jamesfs912/AWG/PCB/PCB_Rev2AFinal/awg.kicad_pcb

## KiCad design PCB/PCB_Rev2AFinal/awg.kicad_pcb (2023-10-04)

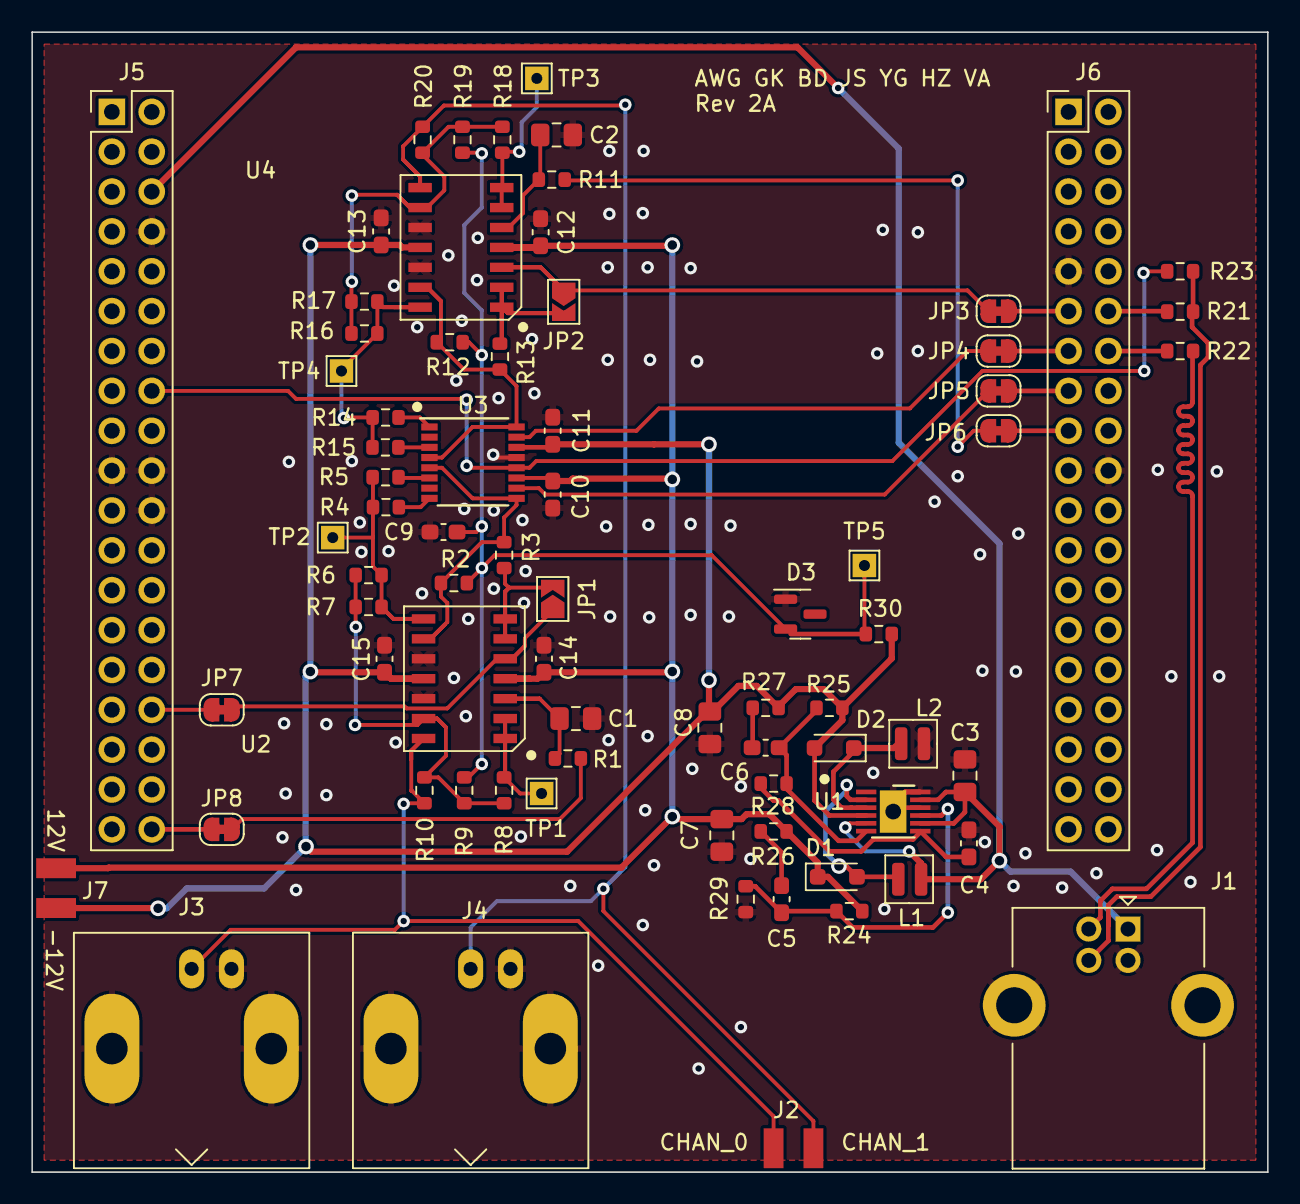
[picture p1: board awg.kicad_pcb from above]

Board: 2 copper layers, 78.7 x 72.6 mm, 74 parts (0 on the bottom side), 47 nets.

Parts:
C1, C2, C3, C7, C8: 10u; C_0805_2012Metric_Pad1.18x1.45mm_HandSolder
C4, C9, C10, C11, C12, C13, C14, C15: 100n; C_0603_1608Metric_Pad1.08x0.95mm_HandSolder
C5, C6: 120p; C_0603_1608Metric_Pad1.08x0.95mm_HandSolder
D1, D2: NSR0530; D_SOD-323_HandSoldering
D3: LM4040-5; SOT-23
J1: USB_B; USB_B_Lumberg_2411_02_Horizontal
J2: 02x02; 2x02
J3, J4: BNC; BNC_Amphenol_B6252HB-NPP3G-50_Horizontal
J5: nuc303_LEFT; PinHeader_2x19_P2.54mm_Vertical
J6: nuc303_RIGHT; PinHeader_2x19_P2.54mm_Vertical
J7: 2x01; 1x02
JP1, JP2: SJ; SolderJumper-2_P1.3mm_Open_TrianglePad1.0x1.5mm
JP3, JP4, JP5, JP6, JP7, JP8: JP; SolderJumper-2_P1.3mm_Bridged_RoundedPad1.0x1.5mm
L1, L2: 4.7u; NRH2410
R1, R2, R5, R6, R7, R9, R10, R11, R12, R15, R16, R17, R19, R20, R28, R29: 10K; R_0603_1608Metric
R3, R8, R13, R18: 3K3; R_0603_1608Metric
R4, R14, R26, R27, R30: 1K; R_0603_1608Metric
R21, R22: 22; R_0603_1608Metric
R23: 1K5; R_0603_1608Metric
R24: 110k; R_0603_1608Metric
R25: 100k; R_0603_1608Metric
TP1, TP2, TP3, TP4, TP5: TestPoint; TestPoint_THTPad_1.5x1.5mm_Drill0.7mm
U1: r1283; DFN-12
U2, U4: Opamp_Quad; SOIC-14
U3: DG403; TSSOP-16-1EP_4.4x5mm_P0.65mm

Connections:
+3.3V: J5.16 (3V3), R23.2, U3.12 (VL)
+5V: C3.1, J1.1 (VBUS), J5.6 (E5V), L1.1, U1.5 (CE), U1.8 (Vcc), U1.11 (PVcc)
+12V: C7.1, C10.2, C12.1, C14.1, D1.1 (K), J7.1, R24.1, R26.1, U2.4 (V+), U3.11 (V+), U4.4 (V+)
-5V: C9.1, D3.2 (A), R2.1, R9.2, R12.1, R19.2, R30.1, TP5.1
-12V: C8.2, C11.2, C13.2, C15.2, D2.2 (A), J7.2, R25.1, R27.1, R30.2, U1.4 (Voutn), U2.11 (V-), U3.14 (V-), U4.11 (V-)
/C0_FB: R2.2, R3.2, U2.9 (-), U3.5 (S4), U3.9 (S2)
/C0_IN: JP1.1 (A), JP7.2 (B), U2.5 (+)
/C0_OUT_G: R4.2, R5.2, R6.2, R7.1, TP2.1, U2.8
/C0_OUT_GO: J2.1, J3.1 (In), R10.2, U2.14
/C0_PWM_OFF: JP8.2 (B), R1.1
/C0_S_GAIN: JP5.1 (A), U3.10 (IN2)
/C0_V_OFF: R8.1, TP1.1, U2.1, U2.2 (-)
/C1_FB: R12.2, R13.2, U3.4 (S3), U3.16 (S1), U4.13 (-)
/C1_IN: JP2.1 (A), JP3.1 (A), U4.3 (+)
/C1_OUT_G: R14.2, R15.1, R16.1, R17.1, TP4.1, U4.14
/C1_OUT_GO: J2.2, J4.1 (In), R20.2, U4.8
/C1_PWM_OFF: JP6.1 (A), R11.1
/C1_S_GAIN: JP4.1 (A), U3.15 (IN1)
/C1_V_OFF: R18.1, TP3.1, U4.6 (-), U4.7
/D+: J1.3 (D+), R21.2, R23.1
/D-: J1.2 (D-), R22.2
/USB_D+: J6.12 (PA12), R21.1
/USB_D-: J6.14 (PA11), R22.1
GND: C1.2, C2.2, C3.2, C4.2, C7.2, C8.1, C9.2, C10.1, C11.1, C12.2, C13.1, C14.2, C15.1, D3.1 (K), J1.4 (GND), J1.5 (Shield), J2.3, J2.4, J3.2 (Ext), J4.2 (Ext), J5.8 (GND), J5.19 (GND), J5.20 (GND), J5.22 (GND), J6.9 (GND), J6.20 (GND), L2.2, R29.1, U1.10 (GND), U1.12 (PGND), U1.13 (GND), U2.10 (+), U2.12 (+), U3.13 (GND), U4.10 (+), U4.12 (+)
unnamed: C5.1, R26.2
unnamed: C6.1, R27.2
unnamed: D1.2 (A), L1.2, U1.2 (Lx1)
unnamed: D2.1 (K), L2.1, U1.3 (Lx2)
unnamed: J5.32 (PA4), JP7.1 (A)
unnamed: J5.38 (PC0), JP8.1 (A)
unnamed: J6.11 (PA5), JP3.2 (B)
unnamed: J6.13 (PA6), JP4.2 (B)
unnamed: J6.15 (PA7), JP5.2 (B)
unnamed: J6.17 (PB6), JP6.2 (B)
unnamed: JP1.2 (B), R3.1, U2.6 (-), U2.7
unnamed: JP2.2 (B), R13.1, U4.1, U4.2 (-)
unnamed: C5.2, R24.2, R29.2, U1.9 (Vfb1)
unnamed: C6.2, R25.2, R28.1, U1.6 (Vfb2)
unnamed: C4.1, R28.2, U1.7 (Vref)
unnamed: C1.1, R1.2, U2.3 (+)
unnamed: R6.1, R7.2, R8.2, R9.1, R10.1, U2.13 (-)
unnamed: R14.1, U3.1 (D1)
unnamed: R15.2, U3.3 (D3)
unnamed: R4.1, U3.8 (D2)
unnamed: R5.1, U3.6 (D4)
unnamed: C2.1, R11.2, U4.5 (+)
unnamed: R16.2, R17.2, R18.2, R19.1, R20.1, U4.9 (-)
