jamesfs912/AWG/MCU/Core/Src/main.c

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
/* Includes ------------------------------------------------------------------*/
#include "main.h"
#include "usb_device.h"

/* USER CODE BEGIN Includes */
#include "interface.h"
/* USER CODE END Includes */

DAC_HandleTypeDef hdac1;
DMA_HandleTypeDef hdma_dac1_ch1;
DMA_HandleTypeDef hdma_dac1_ch2;

TIM_HandleTypeDef htim2;
TIM_HandleTypeDef htim6;
TIM_HandleTypeDef htim7;

/* USER CODE BEGIN PV */
uint16_t dc_volt1[256] = {2048, 2048};

/* USER CODE END PV */

void SystemClock_Config(void);
static void MX_GPIO_Init(void);
static void MX_DMA_Init(void);
static void MX_DAC1_Init(void);
static void MX_TIM2_Init(void);
static void MX_TIM6_Init(void);
static void MX_TIM7_Init(void);
/**
  * @brief  The application entry point.
  * @retval int
  */
int main(void)
{
  /* MCU Configuration--------------------------------------------------------*/

  /* Reset of all peripherals, Initializes the Flash interface and the Systick. */
  HAL_Init();

  /* Configure the system clock */
  SystemClock_Config();

  /* Initialize all configured peripherals */
  MX_GPIO_Init();
  MX_DMA_Init();
  MX_USB_DEVICE_Init();
  MX_DAC1_Init();
  MX_TIM2_Init();
  MX_TIM6_Init();
  MX_TIM7_Init();
  /* USER CODE BEGIN 2 */

  HAL_DAC_Start_DMA(&hdac1, DAC_CHANNEL_1, (uint32_t*) dc_volt1, (uint32_t) 2, DAC_ALIGN_12B_R);
  HAL_TIM_Base_Start(&htim6);
  HAL_DAC_Start_DMA(&hdac1, DAC_CHANNEL_2, (uint32_t*) dc_volt1, (uint32_t) 2, DAC_ALIGN_12B_R);
  HAL_TIM_Base_Start(&htim7);


  volatile int a = offsetof(RECV_Packet, packet_type);
  volatile int b = offsetof(RECV_Packet, Content.AWG_SET.channel);
  //volatile int c = offsetof(RECV_Packet, Content.AWG_SET.temp);
  volatile int d = offsetof(RECV_Packet, Content.AWG_SET.gain);
  volatile int e = offsetof(RECV_Packet, Content.AWG_SET.PSC);
  volatile int f = offsetof(RECV_Packet, Content.AWG_SET.ARR);
  volatile int g = offsetof(RECV_Packet, Content.AWG_SET.CCR_offset);
  volatile int h = offsetof(RECV_Packet, Content.AWG_SET.numSamples);
  volatile int o = offsetof(RECV_Packet, Content.AWG_SET.phaseARR);
//  int k = offsetof(RECV_Packet, Content.AWG_SET.channel);


  static_assert(sizeof(RECV_Packet) <= 64);

	HAL_TIM_PWM_Start(&htim2, TIM_CHANNEL_1);
	HAL_TIM_PWM_Start(&htim2, TIM_CHANNEL_2);
	TIM2->CCR1 = 2048;
	TIM2->CCR2 = 2048;

  /* USER CODE END 2 */

  /* Infinite loop */
  /* USER CODE BEGIN WHILE */
	while (1) {
    /* USER CODE END WHILE */

    /* USER CODE BEGIN 3 */

	}
  /* USER CODE END 3 */
}

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
