jamesfs912/AWG/MCU/Core/Src/interface.h

#ifndef SRC_INTERFACE_H_
#define SRC_INTERFACE_H_

#include <stdint.h>

#define AWG_SAMPLES (1024 * 4)
#define AWG_NUM_CHAN 2
#define MAGIC_NUM 0x42
#define HS_STRING_LEN 4
#define ACK_STRING_LEN 8

#define PACK __attribute__((packed))

extern uint8_t awg_lut[AWG_NUM_CHAN][AWG_SAMPLES*2];

typedef struct {
    uint8_t packet_type;
    union {
        struct { // packet_type = 0
            uint8_t handshake_string[HS_STRING_LEN];
        } PACK HandShake;
        struct { // packet_type = 1
            uint8_t channel;
            uint8_t gain;
            //uint8_t temp;
            uint16_t PSC;
            uint16_t ARR;
            uint16_t CCR_offset;
            uint16_t numSamples;
            uint16_t phaseARR;
        } PACK AWG_SET;
    } PACK Content;
} PACK RECV_Packet;

typedef struct PACK {
    uint8_t packet_type;
    uint8_t ack_string[ACK_STRING_LEN];
} TRANS_Packet;

void GotCDC_64B_Packet(char *ptr);

#endif /* SRC_INTERFACE_H_ */
