jamesfs912/AWG/(commit log)

2023-02-26 Add files via upload
    Python programs that create various waveforms plus a hand drawn user defined waveform using the matlab library. All .py files produce two csv files, one is a graphical representation of the wave with two columns. The other csv file is for waveforms specifically as they only accept one column containing the amplitudes. I have all waveforms set to 1 Hz and an amplitude of 1 as default.
    [AWG.csv, AWG_graph.csv, sawtooth_wave.csv, sawtooth_wave_graph.csv, sine_wave.csv, sine_wave_graph.csv, square_wave.csv, square_wave_graph.csv]
2023-02-26 Add files via upload
    Ok since I am programming the MCU I wrote some python programs for sine, triangle, square, sawtooth waveforms and a hand drawn user defined waveform. When you run the specific .py file the output producesa csv file that can be opened in excel and viewed as a graph. Most waveforms accept csv files so I plan on using this in the future. You could technically draw the waveform, save the csv file onto a usb drive and insert it into one of GMU's waveform generators to produce the custom signal. The GUI is taken from matlab. When you run the program a popup window should appear.
    [AWG.csv, sawtooth_wave.csv, sine_wave.csv, square_wave.csv, triangle_wave.csv]
2023-02-27 Add files via upload
    basic gui with amp, offset and freq. arbitrary freq doesn't work
    [main.py]
2023-04-23 Added PCB
    [sdp.kicad_pcb, sdp.kicad_sch]
2023-06-15 Unit conversion complete + misc bug fixes
    [main.py]
2023-10-04 PCB rev2
    [FormulaCalculator.ods, PSU.kicad_sch, awg.kicad_pcb, awg.kicad_sch]
2023-10-04 PCB rev2 forgot stuff
    [awg.kicad_pcb, awg.kicad_sch]
2023-10-05 moved wave gen to wavegen.py added connection.py for future stuff with handling the MCU connection, can't test cuz no board added status label and connect button, basic integration with connection.py
    [FormulaCalculator.ods]
2023-10-15 removed LCD, fixed disconnect bug
    [FormulaCalculator.ods]
2023-10-18 test scripts, auto connect
    [awg.kicad_sch]
2023-10-20 dc voltage update
2023-10-31 fix connection, sending phase, setting phase
    [MCU_test.ioc, channal.py, connection.py, interface.c, interface.h, main.c, main.py, wave_drawer.py]
2023-11-03 Update wave_drawer.py
    add/delete waveforms.
    Fixing out of bounds errors
    [wave_drawer.py]
2023-11-06 refactor for synchronization part 1
    [FormulaCalculator.ods]
2023-11-11 fixed dumb error for creat_file
    [wave_drawer.py]
2023-11-12 all should work
    [PSU.kicad_sch, awg.kicad_pcb, awg.kicad_sch]
2023-11-22 Added documentation to majority of functions.
    [waveform.csv]
